andrewbierer/Open_Irr/Supporting Documents/Open_Irr classes brainstorm 07_18_2024.xlsx

Sheet: Sheet1
class | vectorName | vectorElementName | vectorElementType | vectorElementValues | note | class | vectorName | vectorElementName
valveConfig | valveOne | latching | bool | 1 | TRUE | valveConfig | valveOne | latching
valveConfig | valveOne | latching | bool | 0 | FALSE |  |  | bidirectionalFlow
valveConfig | valveOne | bidirectionalFlow | bool | 1 | TRUE |  |  | idleStateNormallyClosed
valveConfig | valveOne | bidirectionalFlow | bool | 0 | FALSE |  |  | powerlossReturnToStateLogic
valveConfig | valveOne | idleStateNormallyClosed | bool | 1 | TRUE |  |  | inrushCurrentAmps
valveConfig | valveOne | idleStateNormallyClosed | bool | 0 | FALSE |  |  | holdingCurrentAmps
valveConfig | valveOne | powerlossReturnToStateLogic | bool | 1 | TRUE |  |  | dutyCycleType
valveConfig | valveOne | powerlossReturnToStateLogic | bool | 0 | FALSE |  |  | dutyCycleTimeMS
valveConfig | valveOne | inrushCurrentAmps | uint8_t |  | single element |  |  | dutyCycleRatio
valveConfig | valveOne | holdingCurrentAmps | uint8_t |  | single element |  |  | wiringThreeWay
valveConfig | valveOne | dutyCycleType | uint8_t |  | single element, 3 choice selection: continuous (0), intermittent(1), pulse(2) |  | valveTwo
valveConfig | valveOne | dutyCycleTimeMS | uint18_t |  | single element |  | valveThree
valveConfig | valveOne | dutyCycleRatio | double |  | single element |  | valveFour
valveConfig | valveOne | wiringThreeWay | bool | 1 | TRUE
valveConfig | valveOne | wiringThreeWay | bool | 0 | FALSE

Sheet: valvetesting
model | link | power | valveFittings | latching | bidirectionalFlow | idleStateNormallyClosed | powerlossReturnToStateLogic | inrushCurrentAmps | holdingCurrentAmps | dutyCycleType | dutyCycleTimeMS | dutyCycleRatio | wiringThreeWay | pressureMinPsi | pressureMaxPsi | resistanceOhm | datasheet
VALVE-LAT-NPT-0_75 | https://www.vegetronix.com/Products/g/Valves/VALVE-LAT-NPT-0_75/ | 9VDC | 3/4NPT | 1 |  | 1 |  |  |  | pulse | 50 |  | 0 | 15 | 150 | 5.5
GCS3052 | https://www.dripdepot.com/irrigation-valve-with-dc-latching-solenoid-size-three-quarter-inch-fpt | 15-24VDC | 3/4to2FPT | 1 |  | 1 |  |  |  | pulse | 50 |  | 1 | 7 | 145 | 10
GCS3051 | https://www.dripdepot.com/irrigation-valve-with-dc-latching-solenoid-size-three-quarter-inch-fpt | 6-18VDC | 3/4to2FPT | 1 |  | 1 |  |  |  | pulse | 50 |  | 0 | 7 | 145 | 3
BVS6CE-XR22 | https://www.electricsolenoidvalves.com/1-inch-stainless-steel-motorized-electric-ball-valve-2-wire-auto-return/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 | 9-24VAC/VDC | 1NPT | 0 | 1 | 1 | 0 |  | 500mA | continuous | 60000 | 100 | 0 | 0 | 185
BVS6CE-XR33-J | https://www.electricsolenoidvalves.com/1-inch-stainless-steel-electric-ball-valve-3-wire/ | 9-24VAC/VDC | 1NPT | 0 | 1 | 1 | 0 |  | 500mA | continuous | 60000 | 100 | 1 | 0 | 185
