andrewbierer/Open_Irr/Supporting Documents/Gerber_and_Schematics/Schematic_HardwareX_Open_Irr_Gateway_2023-04-07.pdf

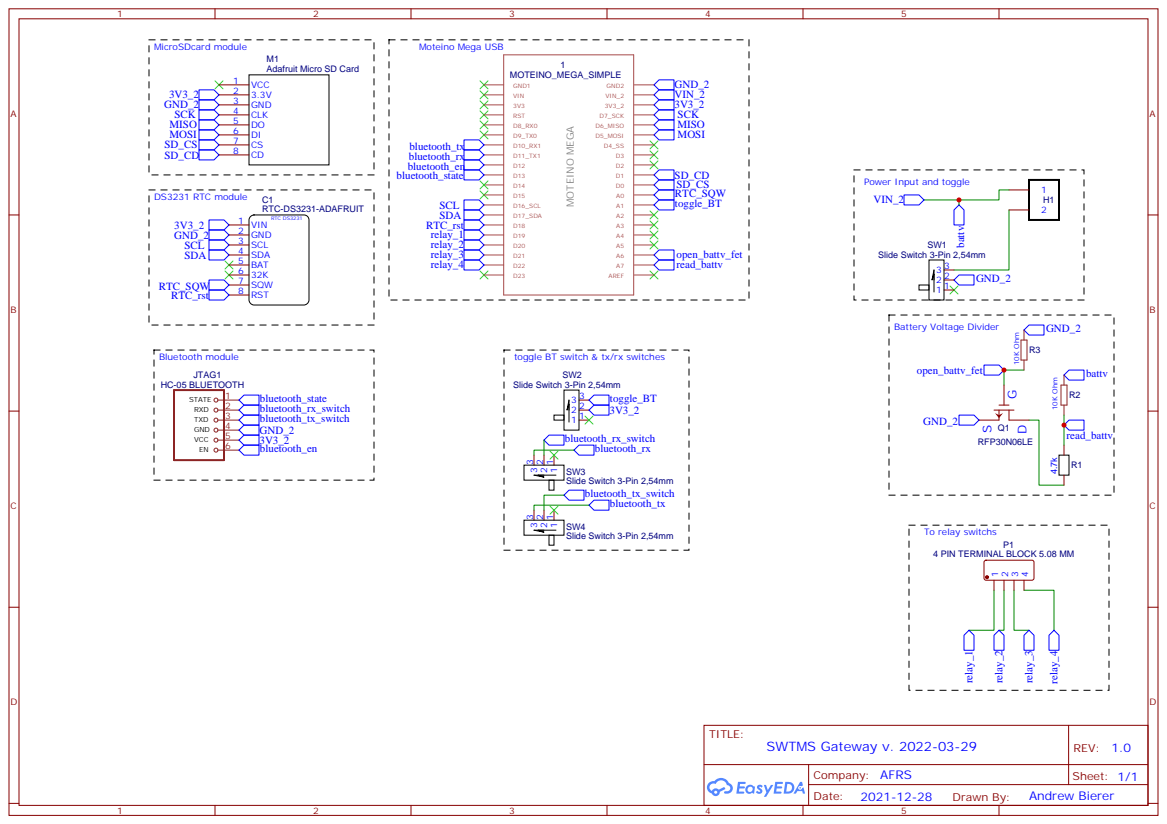
[picture p10: page 1]

Adafruit Micro SD Card

Power Input and toggle
VIN_2

toggle BT switch & tx/rx switches

4 PIN TERMINAL BLOCK 5.08 MM
