andrewbierer/Open_Irr/Supporting Documents/Gerber_and_Schematics/Schematic_HardwareX_Open_Irr_Node_2023-04-07.pdf

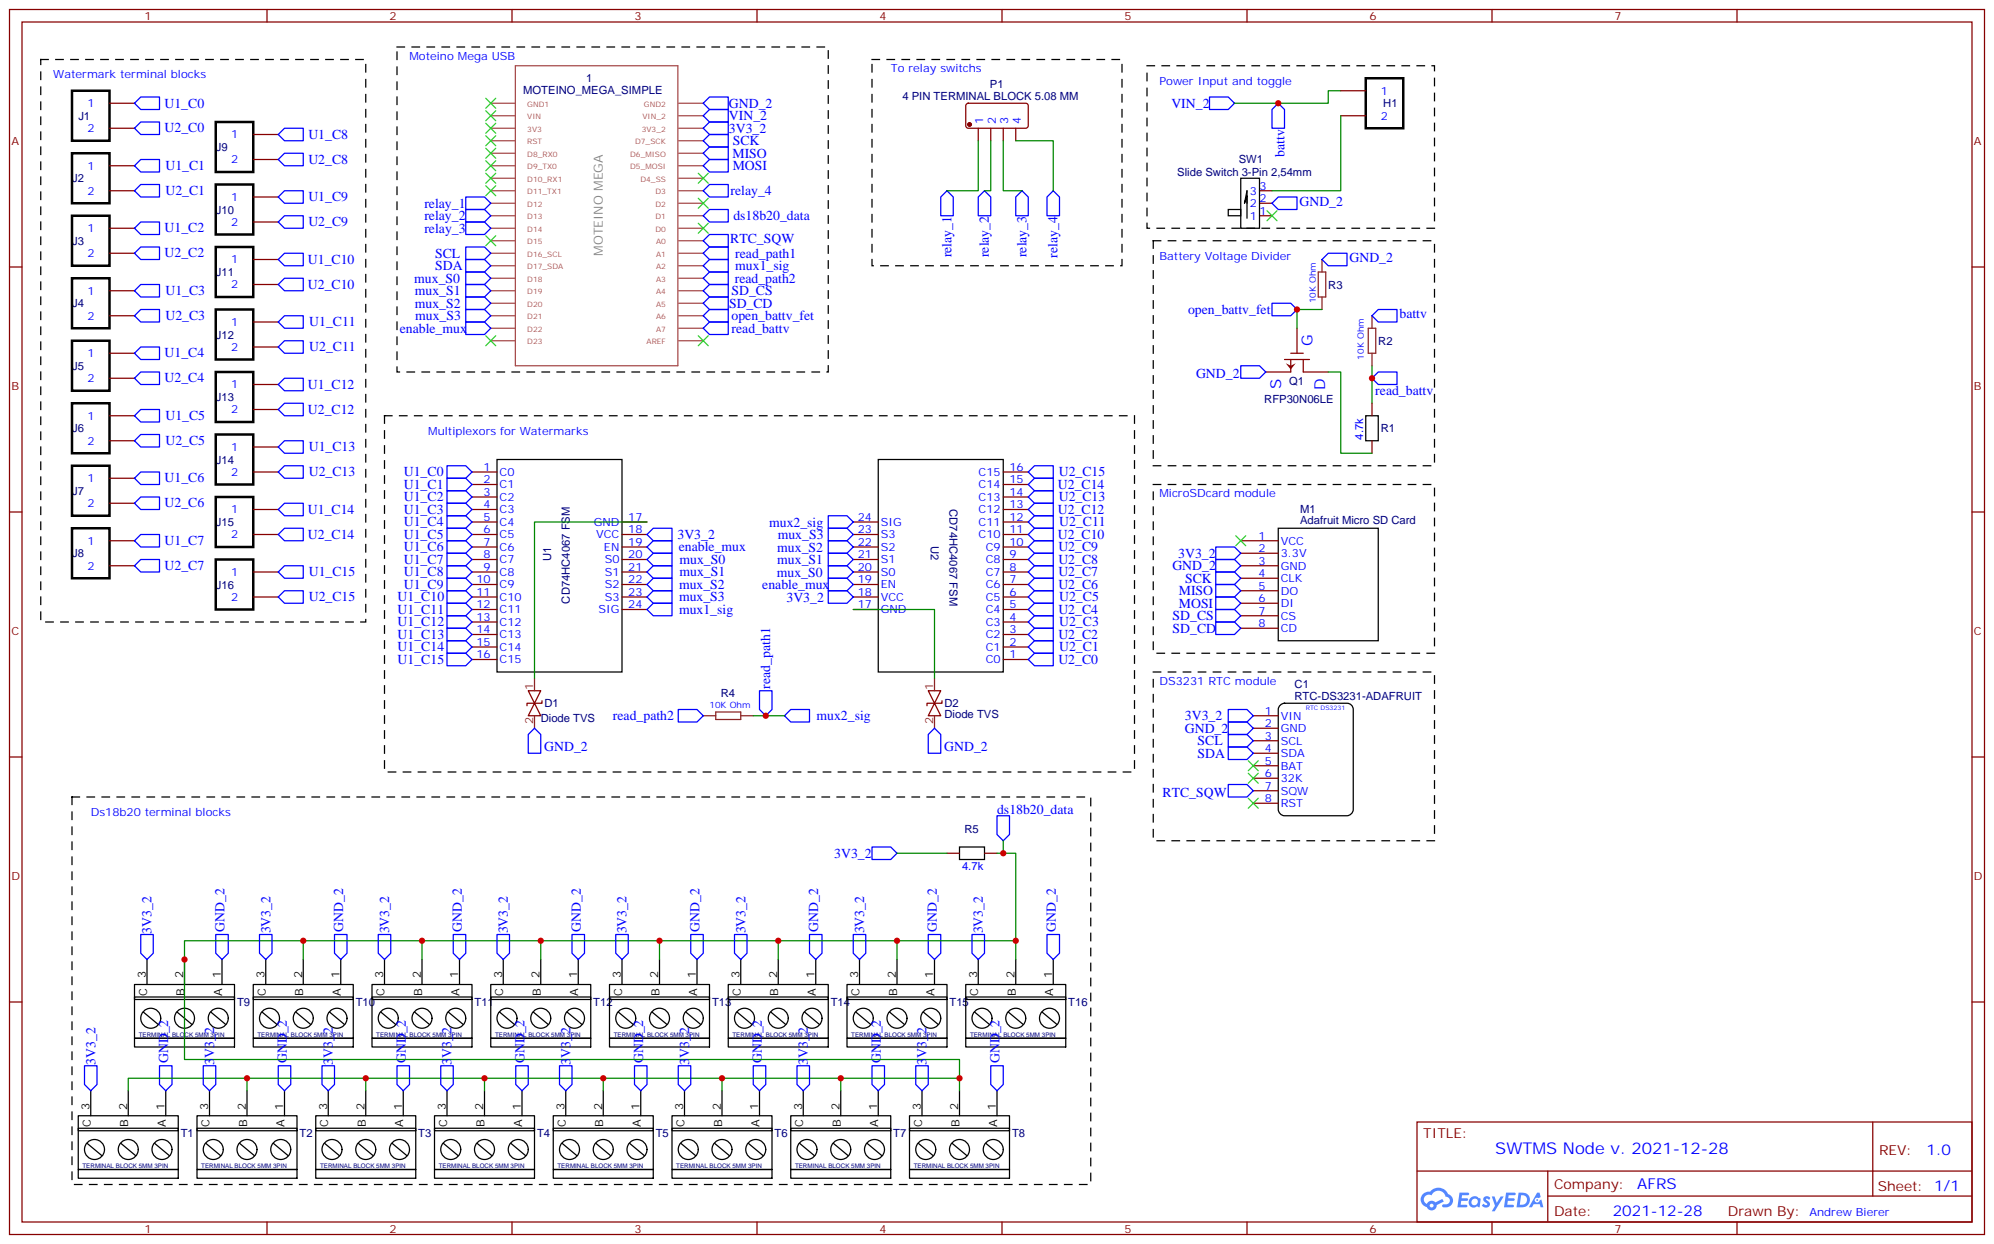
[picture p11: page 1]

To relay switchs
4 PIN TERMINAL BLOCK 5.08 MM

Power Input and toggle
VIN_2

GND 17 VCC 18 EN 19 S0 20 S1 21 S2 22 S3 23 SIG 24
