andrewbierer/Open_Irr/(commit log)

2022-09-21 Add files via upload
    Upload of Gerber files and Schematics for HardwareX submission
2024-07-19 Look up table for irrigation valves
    Contains various valve types / descriptions for evaluation by firmware.
    [Open_Irr classes brainstorm 07_18_2024.xlsx]
2025-03-27 Update Open_Irr_Node.ino spring 2025
    This is intended to be the last release before more substantive changes are made in the rev "2". Notable changes include concurrent handling of irrigation events for each group, which has changed several functions.
2026-05-10 Improve readability and update watermark sensor logic
    adjust logic for reading watermark sensors.
